charudatt/ESP8266-Si4732-SSB-Receiver/docs/HARDWARE PROTOTYPE.jpeg

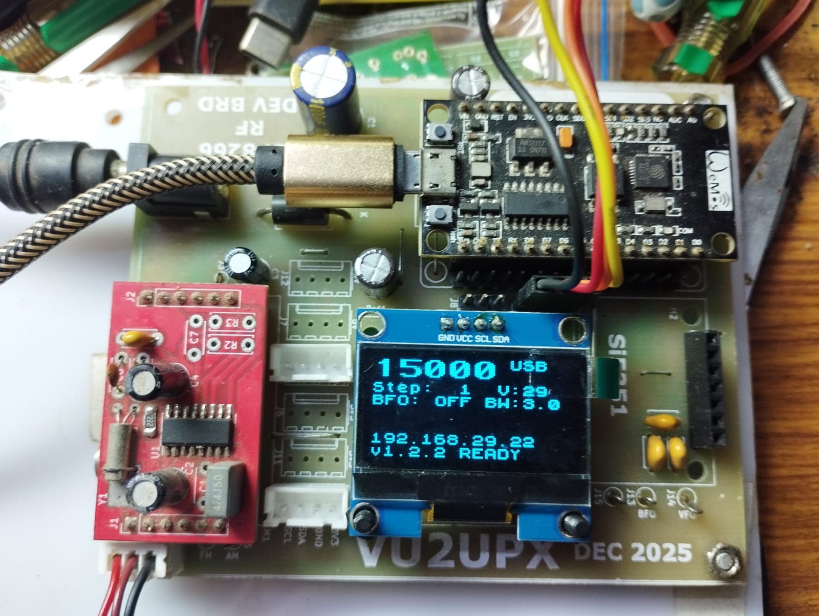
docs/HARDWARE PROTOTYPE.jpeg
