charudatt/ESP8266-Si4732-SSB-Receiver/docs/User_Manual.docx

ESP8266-Si4732-SSB-Receiver

Firmware: v1.2.4 | GitHub release baseline

Hardware: ESP8266 · Si4732 · 1.3" SH1106 OLED · Rotary Encoder
Firmware control: Configurable Soft-AP or STA Web UI + local encoder

# 1. Introduction

This project is a compact HF receiver based on the Silicon Labs Si4732 DSP radio IC, controlled by an ESP8266 microcontroller. It supports AM, LSB, and USB (SSB) reception across medium-wave and shortwave bands. Local control is provided by a rotary encoder and a 1.3" SH1106 OLED display. Remote control is available through a Wi-Fi Soft Access Point and a built-in web interface.

SSB operation uses the official PU2CLR SI4735 Arduino library with the SSB firmware patch for Si4732-A10 / Si4735-D60 devices.

# 2. Features

- AM / LSB / USB reception (SSB patch auto-loaded)
- Band presets: MW, 80 m, 40 m, 20 m, 15 m, 10 m, and ALL (150 kHz–30 MHz)
- Rotary encoder: tune frequency; short press cycles mode; long press toggles BFO
- 1.3" SH1106 128×64 OLED status display
- Configurable Wi-Fi Web UI: AP-first default, remembered STA after WiFiManager setup, with AP fallback
- 10 memory channels (defaults in Config.h; store/recall from web; EEPROM backup)
- Configurable Web Wi-Fi mode, AP/STA credentials, WiFiManager settings, default volume/frequency, and splash delay in Config.h
- Settings and memories retained in EEPROM across power cycles

# 3. Hardware Requirements

Recommended parts:

Item | Notes
ESP8266 | NodeMCU 1.0, Wemos D1 mini, or Generic ESP8266 module (3.3 V)
Radio IC | Si4732-A10 (or Si4735-D60) with support circuitry / module
Display | 1.3" OLED 128×64, SH1106 controller, I2C
Encoder | Rotary encoder with push-button switch
Power | Stable 3.3 V supply for MCU, OLED, and Si4732
Antenna | HF antenna suitable for the bands of interest

Important: Power the Si4732 and OLED from 3.3 V only. Do not apply 5 V to I2C or signal pins.

# 4. Pin Definitions

All pin assignments are defined in Config.h (GPIO numbers). NodeMCU / Wemos “D” labels are shown for convenience.

Symbol (Config.h) | GPIO | Board label | Function
PIN_SCL | 5 | D1 | I2C clock – OLED + Si4732
PIN_SDA | 4 | D2 | I2C data – OLED + Si4732
PIN_SI4732_RST | 2 | D4 | Si4732 RESET (active low)
PIN_ENC_A | 14 | D5 | Rotary encoder channel A
PIN_ENC_B | 12 | D6 | Rotary encoder channel B
PIN_ENC_SW | 13 | D7 | Encoder push-button (to GND)

Wiring notes:

- OLED and Si4732 share the same I2C bus (SDA/SCL).
- Encoder common terminal and switch common to GND; internal pull-ups are enabled in software.
- Si4732 RESET must be connected to GPIO2 (D4).
- Common ground between ESP8266, OLED, Si4732, and encoder.

# 5. Software Libraries

Install the following libraries in the Arduino IDE (Sketch → Include Library → Manage Libraries), and install the ESP8266 board package from the Boards Manager.

Library | Author | Purpose | URL
PU2CLR SI4735 | Ricardo Lima Caratti (PU2CLR) | Si4732/Si4735 control, AM/FM/SSB, patch download | https://github.com/pu2clr/SI4735
U8g2 | olikraus | U8x8 text driver for SH1106 128×64 OLED | https://github.com/olikraus/u8g2
ESP8266 Arduino core | ESP8266 Community | Board support, WiFi, WebServer, EEPROM | https://github.com/esp8266/Arduino

SSB patch header:

The sketch includes patch_init.h (or, depending on library version, patch_ssb_compressed.h) shipped with PU2CLR SI4735. If compilation fails on the patch include, change the #include line near the top of the .ino to the header name provided by your installed library version.

Rotary encoder: Rotary.h / Rotary.cpp (Ben Buxton implementation) are included in the project folder.

# 6. Arduino IDE Setup & Upload

1. Install Arduino IDE 1.8.x or 2.x.

2. Add ESP8266 board URL in Preferences → Additional Boards Manager URLs, then install “esp8266” from Boards Manager.

3. Install PU2CLR SI4735 and U8g2 via Library Manager.

4. Open ESP8266-Si4732-SSB-Receiver.ino (keep Config.h, Rotary.h, Rotary.cpp in the same folder).

5. Select board: NodeMCU 1.0 (ESP-12E Module), Wemos D1 R2 & mini, or Generic ESP8266 Module.

6. Select the correct COM/serial port and upload.

# 7. User Configuration (Config.h)

Edit Config.h before compiling to select Web UI Wi-Fi mode, AP/STA credentials, WiFiManager settings, startup frequency, volume, splash time, and memory presets.

Define / table | Description
AP_SSID | Wi-Fi Soft-AP network name (default: Si4732-Rx)
AP_PASSWORD | Soft-AP password (default: 12345678)
DEFAULT_VOLUME | Startup volume 0–63 (default: 40)
DEFAULT_FREQUENCY | Startup frequency in kHz when EEPROM is empty (default: 7100)
SPLASH_DELAY_MS | Boot screen duration showing AP info, milliseconds (default: 6000)
MEM_TABLE[10] | Default memory channels: frequency (kHz) and mode (1=LSB, 2=USB, 3=AM); 0 = empty

Memory behaviour: empty EEPROM slots are filled from MEM_TABLE. Storing a channel from the web UI writes that slot to EEPROM and overrides the table for that channel until the EEPROM is cleared.

# 8. First Start and Wi-Fi Access

After power-up, the OLED shows the active Web UI Wi-Fi mode and IP address during the splash period. In default AP-first mode the receiver initially creates the Si4732-Rx network at 192.168.4.1. The Web Interface includes a WiFi Manager button; after successful configuration the receiver stores the Wi-Fi setup, restarts, and automatically attempts STA mode on later boots. If the saved network is unavailable, it falls back to AP mode.

Parameter | Value
SSID | Si4732-Rx (or AP_SSID in Config.h)
Password | 12345678 (or AP_PASSWORD in Config.h)
IP address | http://192.168.4.1

In AP mode, connect a phone, tablet or PC to Si4732-Rx and open http://192.168.4.1. In STA mode, open the IP address shown on the OLED or in the Web Interface status panel. No Internet connection is required in AP mode.

The OLED layout is frozen for firmware v1.2.0 and remains unchanged from the documented v1.1.8 layout.


OLED rows: rows 0–1 show frequency and mode; row 2 shows Step and Volume; row 3 shows BFO and bandwidth; rows 4–5 are blank/cleared; row 6 shows the active Web UI IP address; row 7 shows firmware version and status. SSID, RSSI, SNR and Band are intentionally not shown.

# 9. OLED Display Layout

Typical status screen:

Field | Content
Large frequency | Current frequency in kHz (bold 2×2 font)
Mode / band | e.g. LSB and (40m) beside frequency
Step / volume | Tuning step and volume, or MUTE when muted
IP | Soft-AP IP address (usually 192.168.4.1)

# 10. Rotary Encoder Controls

Action | Function
Rotate clockwise | Increase frequency by current step (or BFO +10 Hz when BFO is on)
Rotate counter-clockwise | Decrease frequency by current step (or BFO −10 Hz when BFO is on)
Short press | Cycle mode: LSB → USB → AM → LSB
Long press (~0.6 s) | Toggle BFO fine-tuning mode on/off

Frequency is limited to the active band range when tuning with the encoder. Use the Web Interface frequency field for direct frequency entry across the receiver tuning range.

# 11. Web Interface Controls

The Web Control Interface follows the documented receiver layout and provides frequency, mode, step, tuning, AM/FM/LSB/USB selection, volume, a dedicated MUTE control, BFO, bandwidth, memory STORE/RECALL, WiFi Manager, and receiver status. The RESET control is intentionally absent.

11.1 Connecting to the web UI

- AP mode: join SSID Si4732-Rx (or AP_SSID in Config.h).
- AP mode: enter the AP_PASSWORD from Config.h (default 12345678). STA mode: open the IP address assigned by the existing network.
- Open the IP address shown on the OLED or in the Web Interface status panel.
- If WiFiManager has not yet been configured, press the Web Interface WiFi Manager button. Connect to Si4732-Setup, select the local network and enter its password. After successful setup the receiver restarts and uses STA automatically on subsequent boots.

11.2 Frequency, Mode and Step

The top row contains the frequency field, Mode selector and Step selector. Frequency is entered in kilohertz. The same operating state is reflected in the status panel.

Rule | Detail
Valid range | 150 to 30000 kHz (3 to 5 digits)
Examples | 810 (MW), 7100 (40 m), 14200 (20 m), 28400 (10 m)
Set button | Enabled only when the entry is a valid number in range; otherwise greyed out
Enter key | Same as pressing Set — applies the frequency
While typing | Automatic status refresh does not overwrite the field until you leave it or press Set
After Set | Radio tunes to the frequency; the matching band is selected automatically; mode is kept

11.3 Frequency tuning

The four tuning buttons change frequency in the selected direction. The step size is taken from the Step control.

11.4 Mode and Step size

Mode can be selected from the selector or from the AM / FM / LSB / USB buttons. The Step control determines tuning increments.

Step option | Typical use
1 kHz | Fine tuning / SSB nets
5 kHz | General HF broadcast spacing
9 kHz | MW channel spacing (some regions)
10 kHz | Coarse HF / MW
50 kHz | Fast band exploration
100 kHz | Very fast moves within a wide band

11.5 Volume

The Volume slider provides 0–63 control and displays the current value numerically.

Button | Effect
LSB | Lower sideband SSB — common on 40 m and 80 m amateur segments
USB | Upper sideband SSB — common on 20 m, 15 m, 10 m
AM | Amplitude modulation — broadcast MW/SW

11.6 BFO and Bandwidth

The BFO section contains an ON/OFF control, a centred −16,000 to +16,000 Hz slider in 10 Hz steps, and a numeric value. The Bandwidth selector follows the current AM or SSB mode.

11.7 Receiver status

Control | Behaviour
Vol − | Decrease volume by 2 (minimum 0)
Vol + | Increase volume by 2 (maximum 63)
Mute | Toggles mute. When muted, audio level is set to 0; the button label becomes Unmute and turns red
Unmute | Restores the previous volume setting
Status line | Shows Vol: n, or MUTED when mute is active
OLED | Shows MUTE instead of volume while muted

11.7.1 Status information

The status area reports RSSI, SNR, Si4732 detection, Wi-Fi mode, Wi-Fi IP, uptime, frequency, mode, step, volume, BFO and bandwidth.

11.8 Memory controls

The ten memory channels are also available through the Web Interface. The memory dropdown identifies each channel by number, stored frequency and mode, or shows Empty. STORE writes the selected channel to EEPROM and RECALL restores it.

Control | Behaviour
Memory dropdown | Lists M1–M10 with frequency and mode, or (empty)
MEM Recall | Tunes the radio to the selected channel’s frequency and mode; selects a matching band
MEM Store | Saves the current frequency and mode into the selected slot and updates EEPROM
Status under MEM | Confirms “Stored …” or “Recalled …” or “M slot empty”

Memory operations can be performed with /cmd?a=mem_store&v=<slot> and /cmd?a=mem_recall&v=<slot>.

11.9 Web UI update behaviour

The page refreshes receiver status periodically so the browser remains aligned with the radio. The OLED is not cleared or disturbed by browser updates.

11.10 Quick reference — web controls

Goal | What to use
Go to an exact frequency | Edit large frequency field → Set or Enter
Nudge frequency | UP / DOWN (uses Step)
Change step size | Step dropdown
Switch LSB / USB / AM | Mode buttons
Change band | Band − / Band +
Adjust loudness | Vol − / Vol +
Silence audio | Mute / Unmute
Save current QRG | Select Mn → MEM Store
Recall a channel | Select Mn → MEM Recall

# 12. Band Table

Band | Frequency range
MW | 520–1710 kHz
80m | 3500–4000 kHz
40m | 7000–7300 kHz
20m | 14000–14350 kHz
15m | 21000–21450 kHz
10m | 28000–29700 kHz
ALL | 150–30000 kHz

# 13. Memory Channels

The receiver provides ten memory channels (M1–M10). Each channel stores a frequency (kHz) and a mode (LSB, USB, or AM). You can pre-program defaults in Config.h, load them automatically when EEPROM is empty, and store or recall channels from the web interface.

13.1 How memory storage works

Two layers of storage are used:

- Config.h MEM_TABLE — compile-time defaults. Edit this table in Config.h, then recompile and upload.
- EEPROM — runtime storage on the ESP8266. Values written by MEM Store survive power cycles.
- On boot, each slot is read from EEPROM. If the slot is empty (0 or 0xFFFF), the matching MEM_TABLE entry is used instead.
- MEM Store always writes frequency + mode for the selected slot into EEPROM, overriding the Config.h default for that slot.

13.2 Editing the default table in Config.h

Open Config.h and locate MEM_TABLE. Each line is one channel: { frequency_kHz, mode }. Mode codes: 1 = LSB, 2 = USB, 3 = AM. Use frequency 0 for an empty slot.

Field | Meaning
freq | Frequency in kHz (150–30000). Use 0 to leave the channel empty.
mode | 1 = LSB, 2 = USB, 3 = AM
Array index 0 | Shown on the web UI as M1
Array index 9 | Shown on the web UI as M10

Factory-style defaults shipped in the project:

Channel | Default freq (kHz) | Default mode | Typical use
M1 | 7100 | LSB | 40 m amateur
M2 | 7150 | LSB | 40 m
M3 | 14200 | USB | 20 m amateur
M4 | 14250 | USB | 20 m
M5 | 21100 | USB | 15 m amateur
M6 | 28400 | USB | 10 m amateur
M7 | 3700 | LSB | 80 m amateur
M8 | 810 | AM | MW broadcast example
M9 | — (0) | — | Empty — free for user
M10 | — (0) | — | Empty — free for user

After changing MEM_TABLE, recompile and upload. New defaults apply only to slots that are still empty in EEPROM. To force Config.h defaults again for a slot, clear that EEPROM slot (or the whole EEPROM) — for example by erasing flash / EEPROM, or by implementing a user reset if you add one later.

13.3 Web memory controls

In v1.2.4, memory STORE and RECALL are part of the main Web Control Interface.

Control | How to use | Result
Memory dropdown | Tap the list and choose M1–M10 | Shows stored frequency and mode, or “(empty)”
MEM Recall | Select a non-empty channel, press MEM Recall | Radio tunes to that frequency and mode; band is chosen to match
MEM Store | Tune to desired QRG/mode first, select slot, press MEM Store | Current frequency and mode saved to that slot in EEPROM
Status text | Appears under the MEM buttons after an action | e.g. “Stored 14200 USB -> M3” or “M slot empty”

13.4 Step-by-step: store a channel through the HTTP API

1. Set the receiver to the desired frequency and mode using the encoder or Web Interface.

2. Send /cmd?a=mem_store&v=<slot>, where slot 0–9 corresponds to M1–M10.

3. Confirm the HTTP response and the receiver status.

4. The selected memory slot is written to EEPROM.

13.5 Step-by-step: recall a channel through the HTTP API

1. Send /cmd?a=mem_recall&v=<slot>, where slot 0–9 corresponds to M1–M10.

2. The receiver loads the stored frequency and mode.

3. The receiver selects a suitable band and retunes.

4. OLED and Web Interface status update to the recalled frequency and mode.

Memory slots are available directly from the Web Control Interface and through the HTTP API.

13.6 What is stored per channel

Data | Stored? | Notes
Frequency (kHz) | Yes | Full kHz value, 150–30000
Mode (LSB/USB/AM) | Yes | Restored on recall
Volume | No | Global; not per memory
Step size | No | Global; not per memory
BFO offset | No | Not stored in memory slots
Band index | No | Derived automatically from frequency on recall

13.7 Memory and the rotary encoder

Memory store and recall are performed from the Web Interface. After a recall, the receiver can still be fine-tuned with the encoder or Web Interface tuning controls.

13.8 Quick reference — memory

Goal | Action
Pre-load favourite QRGs at compile time | Edit MEM_TABLE in Config.h → upload firmware
Save what you are listening to | Select Mn → MEM Store
Return to a saved channel | Select Mn → MEM Recall
Clear a logical slot in defaults | Set that MEM_TABLE entry freq to 0 and clear EEPROM for that slot
See what is in a slot | Open the Memory dropdown on the web page

# 14. EEPROM Storage

The ESP8266 keeps receiver state and memory channels in its emulated EEPROM (flash-backed). This section describes the map, when data is written, and how it relates to Config.h defaults.

14.1 Overview

On startup the firmware calls EEPROM.begin(256) and checks byte 0 for an application ID. If the ID matches, last-used settings are restored. Memory channels are always loaded: each slot comes from EEPROM when programmed, or from Config.h MEM_TABLE when the slot is empty.

- Total EEPROM region used by this sketch: 256 bytes (EEPROM_SIZE).
- Application ID (APP_ID): 0x53 (‘S’) stored at address 0.
- Receiver settings block: addresses 1–10.
- Memory channels: 10 slots × 3 bytes starting at address 20 (MEM_EEPROM_BASE).
- Addresses 11–19 are currently reserved / unused.

14.2 Memory map

Address | Size | Content | Notes
0 | 1 byte | APP_ID (0x53) | If not 0x53, settings block is treated as invalid
1 | 1 byte | Volume | 0–63
2 | 1 byte | Band index | Index into the band[] table
3 | 1 byte | Mode | 0=FM, 1=LSB, 2=USB, 3=AM (firmware uses LSB/USB/AM)
4–5 | 2 bytes | Frequency | Big-endian, kHz
6–7 | 2 bytes | BFO | Signed 16-bit, Hz
8 | 1 byte | Step | Tuning step in kHz
9 | 1 byte | SSB bandwidth index | Library bandwidth table index
10 | 1 byte | AM bandwidth index | Library bandwidth table index
11–19 | 9 bytes | Reserved | Unused by current firmware
20–22 | 3 bytes | Memory M1 | freq hi, freq lo, mode
23–25 | 3 bytes | Memory M2 | freq hi, freq lo, mode
… | … | … | Each next channel +3 bytes
47–49 | 3 bytes | Memory M10 | Last memory slot

14.3 Memory channel encoding

Each memory slot uses 3 bytes at address MEM_EEPROM_BASE + (slot × 3), where slot is 0…9:

Offset in slot | Content
+0 | Frequency high byte (kHz >> 8)
+1 | Frequency low byte (kHz & 0xFF)
+2 | Mode (1=LSB, 2=USB, 3=AM)

A frequency of 0 or 0xFFFF is treated as empty. On load, empty slots are filled from MEM_TABLE in Config.h.

14.4 When data is written

Event | What is saved | When
Auto-save settings | APP_ID, volume, band, mode, frequency, BFO, step, BW indexes | About 8 seconds (STORE_AFTER_MS) after the last user activity (encoder or web command)
MEM Store (web) | One memory slot (3 bytes) + commit | Immediately when MEM Store is pressed
Power-off without wait | May lose recent frequency/mode/volume if 8 s idle save not reached | Use a short pause after changes before cutting power if you need retention
First boot / blank EEPROM | Nothing loaded from settings block | Defaults from Config.h (volume, frequency) and MEM_TABLE apply

14.5 Load sequence at boot

1. EEPROM.begin(256).

2. If EEPROM[0] == APP_ID (0x53), load settings from addresses 1–10 (volume, band, mode, frequency, BFO, step, bandwidth indexes).

3. Otherwise keep compile-time defaults (DEFAULT_VOLUME, DEFAULT_FREQUENCY from Config.h).

4. loadMemories(): for each of 10 slots, read 3 bytes from address 20 + 3×slot; if frequency is 0 or 0xFFFF, copy MEM_TABLE[slot] from Config.h.

5. Radio starts on the restored (or default) band/mode/frequency; the active Wi-Fi splash is shown.

14.6 Relationship to Config.h

Item | Source of truth
AP SSID / password | Config.h only (not stored in EEPROM)
Splash delay | Config.h only
DEFAULT_VOLUME / DEFAULT_FREQUENCY | Used only when APP_ID is missing
Last volume, QRG, mode, band, step | EEPROM settings block after first successful save
Memory defaults | Config.h MEM_TABLE until a slot is stored
Memory after MEM Store | EEPROM for that slot

14.7 Clearing or resetting EEPROM

This firmware build does not include a front-panel “factory reset” button. Practical options:

- Erase the ESP8266 flash / EEPROM from the Arduino IDE or esptool, then upload the sketch again (all memories and last-QRG state cleared).
- Change APP_ID in the source and re-upload so the old settings block is ignored (memories at 20+ may still remain until overwritten).
- Overwrite each memory slot from the web UI with new values, or set MEM_TABLE entries to 0 and clear EEPROM if you need empty slots.

14.8 Wear and reliability notes

- ESP8266 EEPROM is emulated in flash; the Arduino core reduces wear with a buffered commit model.
- Auto-save waits 8 seconds of inactivity to avoid writing on every encoder click.
- MEM Store commits immediately — normal for occasional channel saves, not for rapid automated writes.
- Avoid power-cycling during the brief moment of EEPROM.commit() (rare practical issue).

14.9 Quick reference — EEPROM

Question | Answer
Where is last frequency kept? | EEPROM bytes 4–5; restored if APP_ID is valid
Where are memories kept? | Bytes 20–49 (10 × 3)
When is last QRG saved? | ~8 s after last encoder/web activity
When is a memory saved? | Immediately on MEM Store
What if EEPROM is blank? | Config.h defaults for volume/frequency; MEM_TABLE for memories
Are AP credentials in EEPROM? | No — only in Config.h

# 15. Project Files

File | Description
ESP8266-Si4732-SSB-Receiver.ino | Main firmware: radio, OLED, Wi-Fi, web server, memories
Config.h | GPIO map, AP settings, defaults, MEM_TABLE
Rotary.h / Rotary.cpp | Ben Buxton rotary encoder driver
README.md | Brief project notes

# 16. Troubleshooting

Symptom | Suggested action
OLED blank | Check 3.3 V, SDA→GPIO4, SCL→GPIO5, common GND. If needed, switch to the SW_I2C constructor commented in the .ino.
No Soft-AP | Wait for splash; check Serial at 115200. Confirm AP_SSID/AP_PASSWORD in Config.h.
SSB patch compile error | Change #include <patch_init.h> to the patch header name in your PU2CLR library (e.g. patch_ssb_compressed.h).
Frequency Set does nothing | Enter 150–30000 and press Set/Enter. Value must be numeric; Set enables only for a valid entry.
Weak or no audio | Verify Si4732 audio output wiring, antenna, volume not muted, and band/mode appropriate for the signal.
Encoder erratic | Ensure pull-ups (software enabled), short wires, and A/B not swapped if direction feels inverted.

# 17. Notes and Disclaimer

This project is intended for hobby and experimental use. Observe local regulations for radio reception. The SSB patch is used as provided by the PU2CLR library ecosystem; the library author disclaims liability for device damage related to patch loading—proceed at your own risk.

Library documentation: https://pu2clr.github.io/SI4735/ and https://github.com/pu2clr/SI4735

— End of User Manual —

Figure: Frozen v1.2.4 OLED display and Web Control Interface.

# 18. Web Control Wi-Fi Modes

Firmware v1.2.4 uses an AP-first / remembered-STA design. The receiver starts as a local Soft-AP by default. The Web Interface provides a WiFi Manager button; after successful WiFiManager configuration, the receiver restarts and automatically tries STA on later boots. If the saved network is unavailable, it falls back to the normal AP.

## 18.1 Default AP-first mode

In Config.h leave WEB_UI_WIFI_MODE set to WEB_UI_WIFI_MODE_AP. The receiver starts the Si4732-Rx AP at http://192.168.4.1. Press WiFi Manager in the Web Interface to configure a local network. After successful setup the receiver restarts and later boots automatically attempt STA.

## 18.2 Forced Station (STA) mode

Set WEB_UI_WIFI_MODE to WEB_UI_WIFI_MODE_STA when STA should be preferred immediately at startup. Fixed STA credentials may be entered in Config.h, or WiFiManager-saved credentials can be used. If connection fails, the receiver falls back to AP.

## 18.3 WiFiManager from the Web Interface

The WiFi Manager button launches the configuration portal using WIFI_MANAGER_AP_SSID and WIFI_MANAGER_AP_PASSWORD from Config.h. The portal timeout is controlled by WIFI_MANAGER_TIMEOUT_S. A successful configuration is remembered and causes the receiver to restart into STA mode on subsequent boots.

## 18.4 Config.h example

WEB_UI_WIFI_MODE_AP = 0
WEB_UI_WIFI_MODE_STA = 1
WEB_UI_WIFI_MODE = WEB_UI_WIFI_MODE_AP
STA_SSID = ""
STA_PASSWORD = ""

# Use the Web Interface WiFi Manager button for first-time network setup.

The OLED layout remains frozen. Row 6 shows whichever IP address is currently used by the Web Interface, while SSID, RSSI and SNR remain off the OLED.

# v1.2.4 — Current Web Control Interface

This section documents the current frozen OLED layout and Web Control Interface baseline.

## OLED layout

- Rows 0–1: Frequency + reduced-size Mode, separated by one character space.
- Row 2: Step + Volume; V:XX is shifted two character spaces to the right.
- Row 3: BFO + Bandwidth (BW).
- Rows 4–5: explicitly blank/cleared.
- Row 6: active Web Interface IP address.
- Row 7: firmware version + status.
- SSID, RSSI, SNR and Band are intentionally not shown on the OLED.

## Web Control Interface

- Frequency, Mode and tuning controls.
- AM / FM / LSB / USB mode selection.
- Volume and dedicated MUTE control.
- BFO ON/OFF and centred ±16 kHz BFO slider.
- Bandwidth selection.
- Memory dropdown showing channel number, stored frequency and mode; empty channels are labelled Empty.
- STORE and RECALL memory controls.
- WiFi Manager for local-network configuration.
- Receiver status including RSSI, SNR, Wi-Fi mode, IP address and uptime.
- RESET control is intentionally removed.

## Wi-Fi operation

AP mode is the default. The receiver can be configured for STA operation through Config.h and WiFiManager. After successful local-network configuration, the receiver can return in STA mode on subsequent starts. If the saved network is unavailable, the receiver falls back to AP mode so the Web Interface remains accessible.

## Memory operation

The memory selector identifies each channel using its stored frequency and mode, for example “M1 — 7.074 MHz LSB”. Select a channel and use STORE to save the current state or RECALL to restore it.
