charudatt/ESP8266-Si4732-SSB-Receiver/docs/DEV BRD GERB DOC.pdf

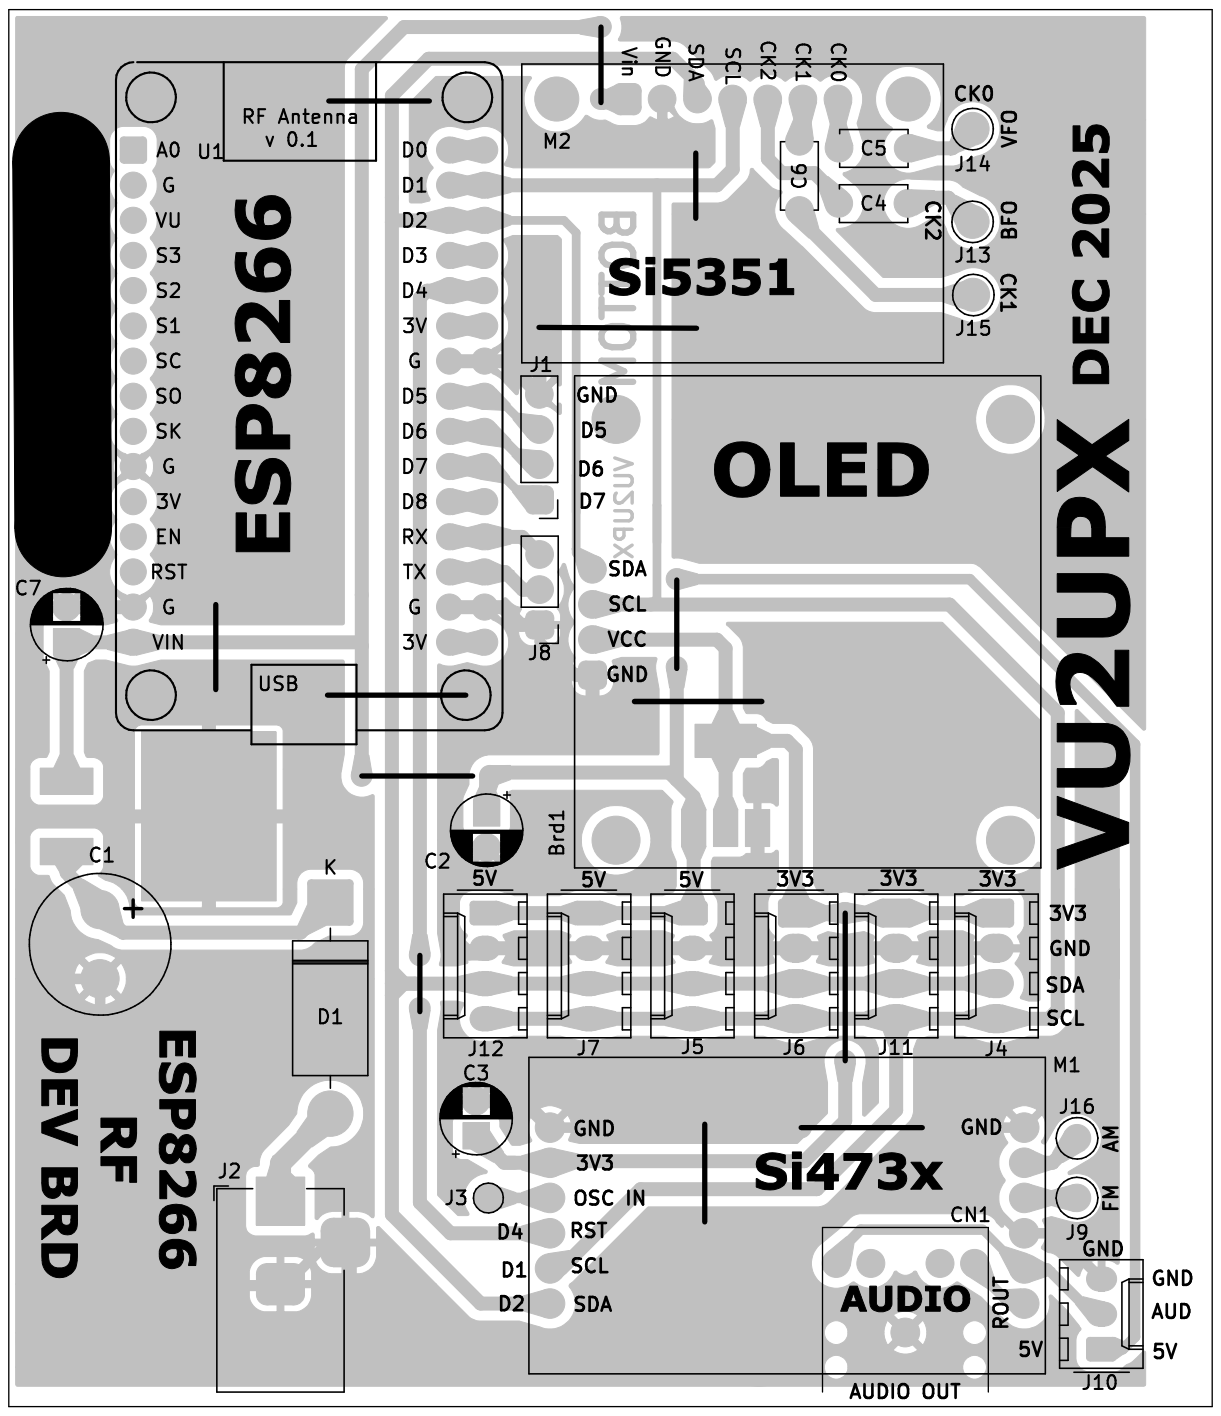
[picture p3: page 1]
