charudatt/ESP8266-Si4732-SSB-Receiver/docs/ESP8266 DEV BRD SCH.pdf

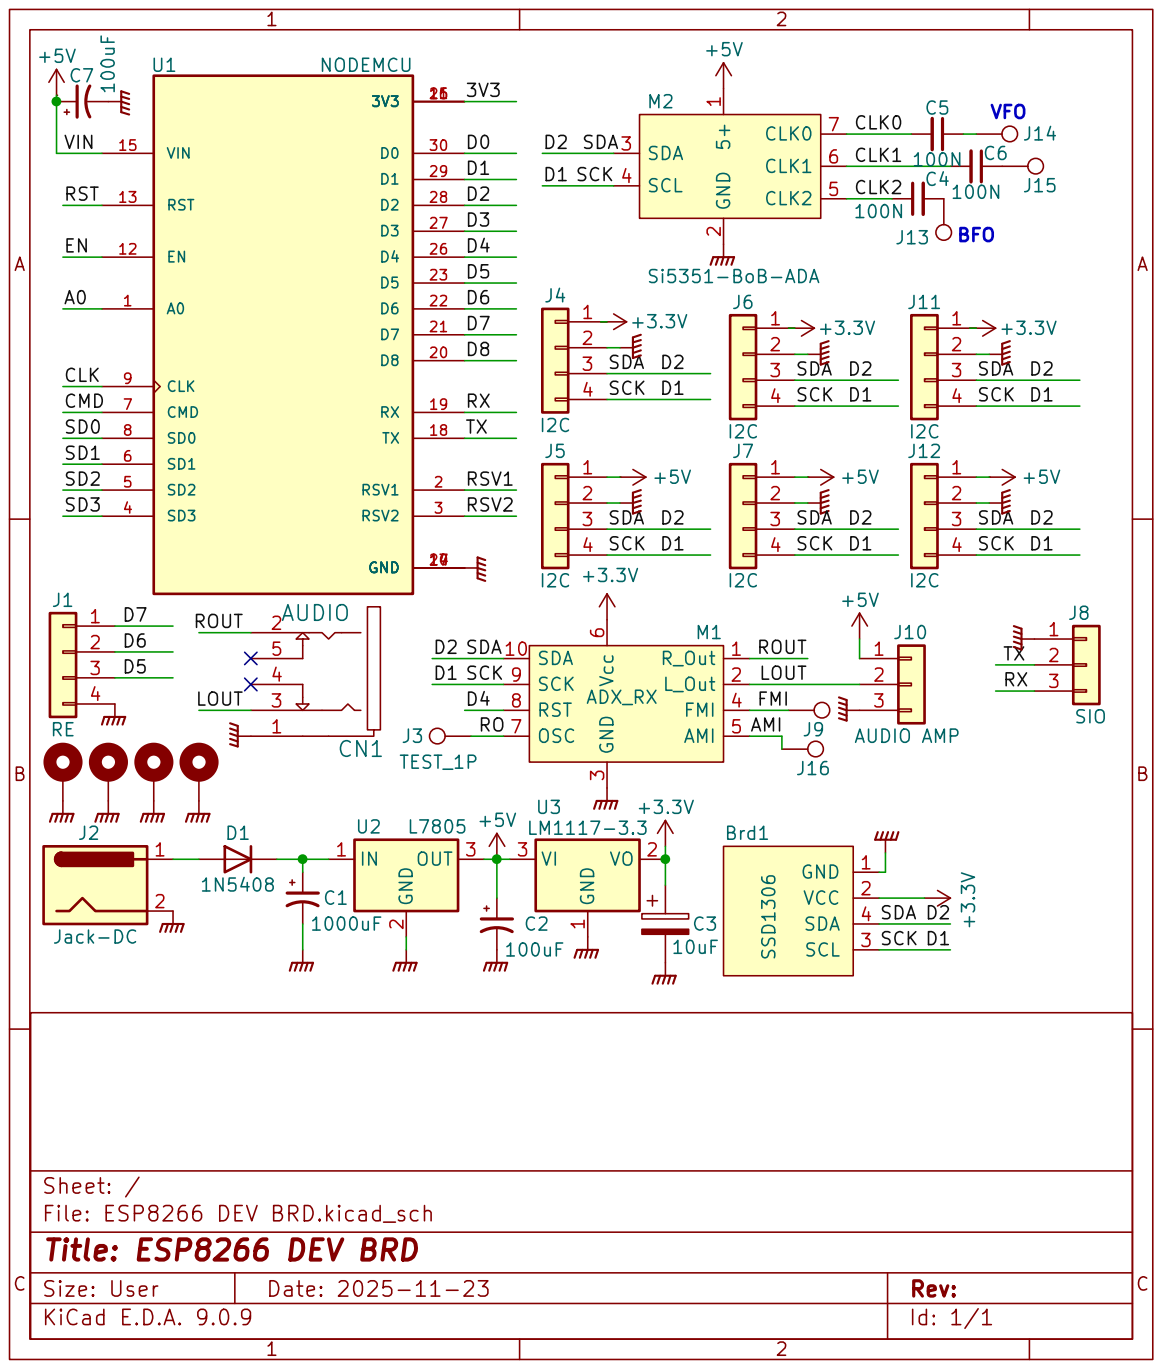
[picture p4: page 1]
