charudatt/ESP8266-Si4732-SSB-Receiver/(commit log)

2026-10-08 Add files via upload
    added schematic and image of the prototype used
2026-10-09 Add files via upload
    v1.3.0 — Stable Web Control Interface
